Unchapped/Servonator/Assembly/20251201_222655.jpg

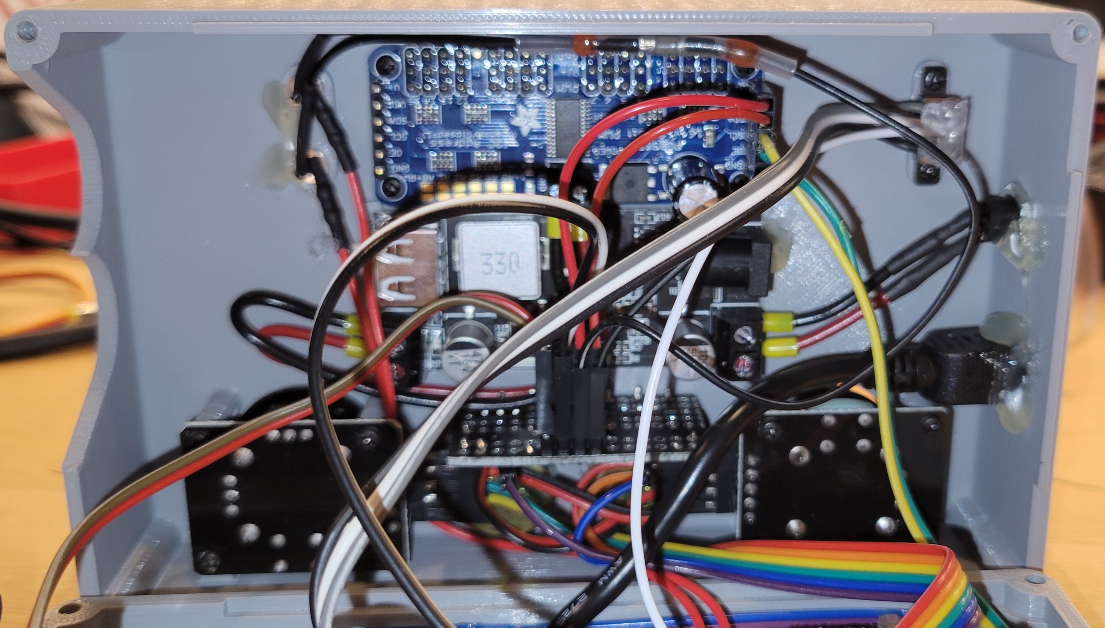
Assembly/20251201_222655.jpg
