Unchapped/Servonator/Assembly/20211024_091539.jpg

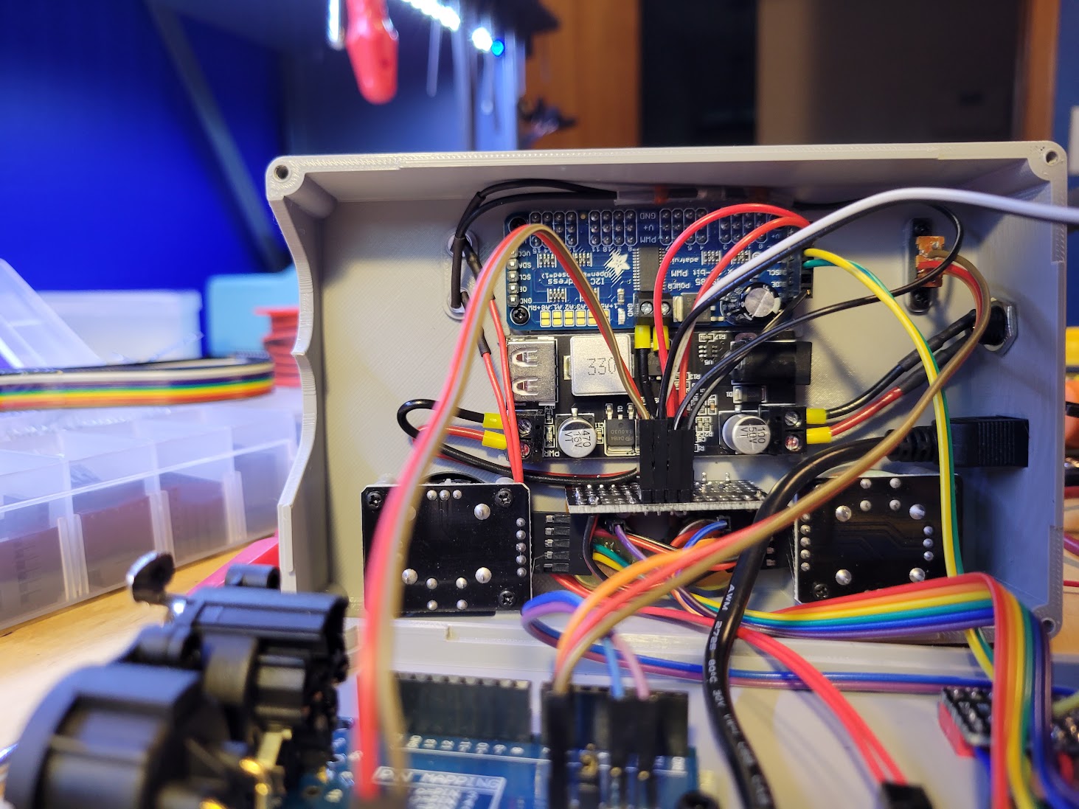
Assembly/20211024_091539.jpg
