Unchapped/Servonator/Servonator_BOM.csv

ASIN | Description | Qty
B01DUHZAT0 | Arduino DMX Sheild | 1
B0713XK923 | Arduino Nano W/Headers | 1
B09BM2F1G3 | Potentiometer Joystick | 2
B06WWQP12J | 10K linear potentiometers with knob | 2
B00EIB0U7A | Adafruit PWM driver | 1
B01NALDSJ0 | 5V Power supply | 1
B01N8VV78D | Power Jack | 1
B07D4CTNYS | DMX Switch | 1
B01G0I0ZZK | Wiring Kit | 1
B08G4X23BR | 5mm Indicator LEDs | 1
B08RWB5CP9 | Solderable Breadboard | 1
B01CKMGD10 | USB R/A extension | 1
