Unchapped/Servonator/Enclosure/Servonator.step

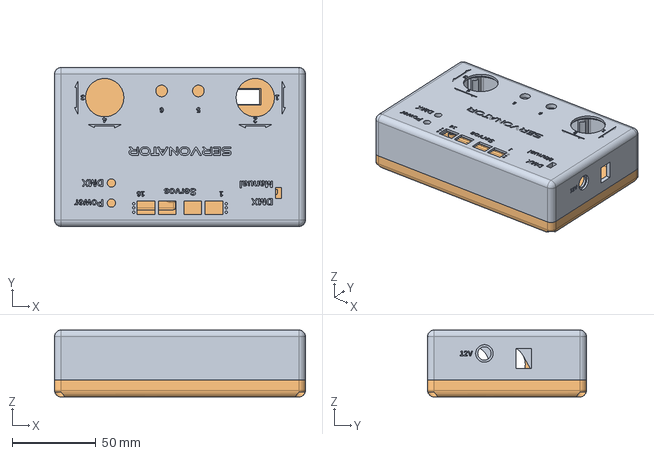
[picture p3: CAD file, 2025-12-26]
Enclosure/Servonator.step
150.0 x 95.0 x 40.0 mm
