Unchapped/Servonator/Enclosure/Servonator_bottom.stl

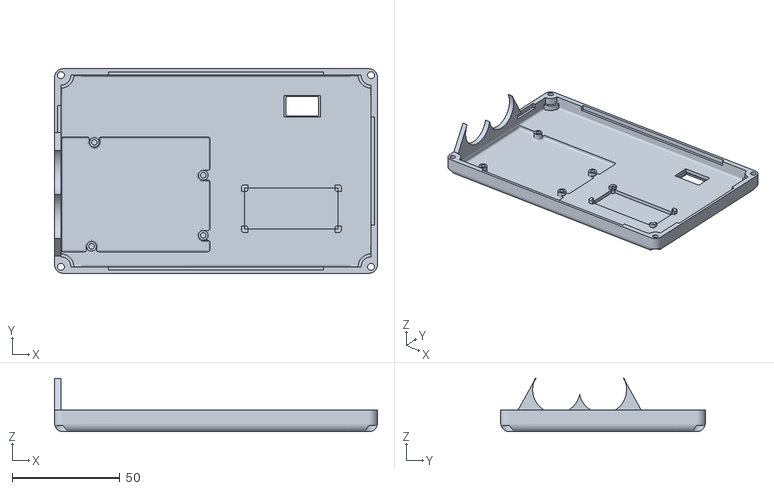
[picture p4: CAD file, 2021-10-24]
Enclosure/Servonator_bottom.stl
150.0 x 95.0 x 24.8
