Unchapped/Servonator/Assembly/20211024_091522.jpg

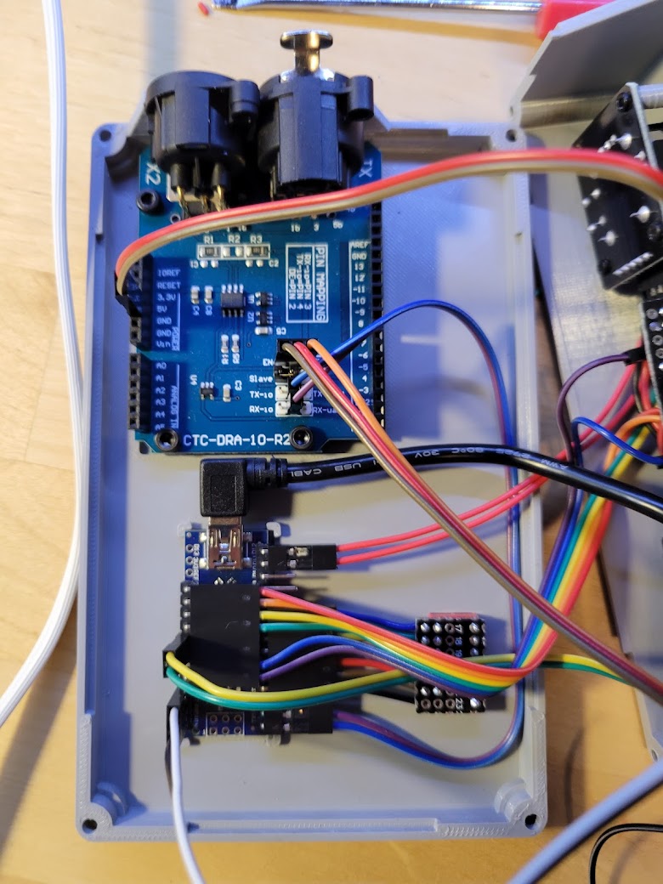
Assembly/20211024_091522.jpg
