Unchapped/Servonator/Assembly/20251201_222728.jpg

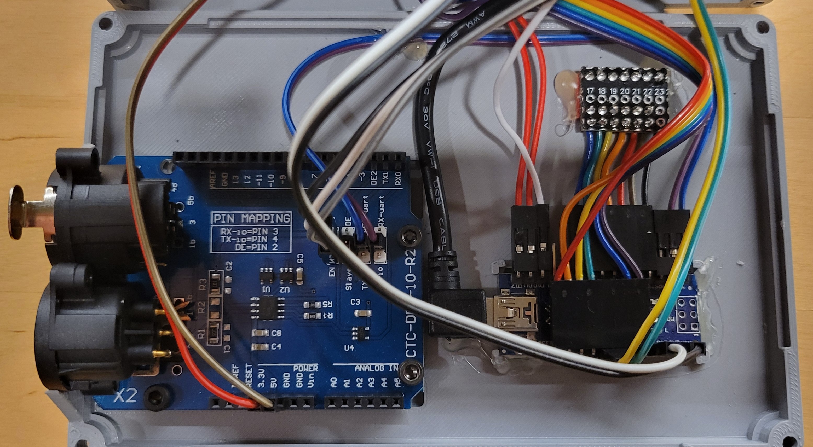
Assembly/20251201_222728.jpg
