Unchapped/Servonator/(threads)

Thread 2 (2021-10-14):

Servo High/Low timing not correctly calibrated

Unchapped, 2021-10-14:
Need to re-calibrate this at some point with an external timebase.
