Unchapped/Servonator/(commit log)

2021-10-24 started project refactor
    [Servonator_bottom.stl]
2021-10-24 added assembly images, final code, and BOM"
    [Servonator_BOM.csv]
2025-11-30 Rewrote Missing HAL Functions
    Some glitchiness still present under DMX control, suspect DMX timeout tripping
    [Servonator.ino]
2025-12-01 started mashing on a timeout fix but need more physical adjustment!
    [Servonator.ino]
2025-12-01 Refactor for locality based on DMX mode switch
2025-12-02 Using a hardware mode switch works
    and the Blink on DMX timeout is pretty intuitive, no servo glitches now in DMX mode
    [Servonator.ino]
2025-12-07 it's totally broken... will need to debug
    [Servonator_Inline_Nano.ino]
2025-12-07 resized DMX buffer to 16 channels, refactored ISR with error guards
    [Servonator_Inline_Nano.ino]
2025-12-08 This seems to work?
    Ominously, my DMX512 board doesn't easily go past channel 192, so I'm worried about edge cases over 256... will have to test?
    [Servonator_Inline_Nano.ino]
2025-12-08 pinning Adafruit PWM Servo library version to 2.4.1 and adding to repo
    removes BusIO dependency and shrinks program size/abstraction
